praetorian555/Baywatchers/README.md

# Baywatchers
This is the official repository for the team Baywatchers that competed at EUROBOT Serbia 2016.
