praetorian555/Baywatchers/Software/Embedded Software/Misc/IR-senzor/IRsenzor.md

U ovom direktorijumu se nalaze potrebni fajlovi za rad IR senzora. Imena nisma promenila, te se sve nalazi u folderu ULTRASOUND, i mejn 
se zove main_ultrasound... Izmenicu to... Dalje, vrednosti nisu skalirane, a zavisnost rastojanja od vrednosti koje se dobijaju iz ADC 
nalaze se u matlab falju... Ne moramo ih cak ni skalirati, dovoljno je da znamo koje vrednosti odgovaraju kom rastojanju.
