praetorian555/Baywatchers/Software/Embedded Software/Misc/RS485Komunikacija.pdf

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

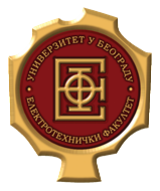
[picture p3: figure]

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

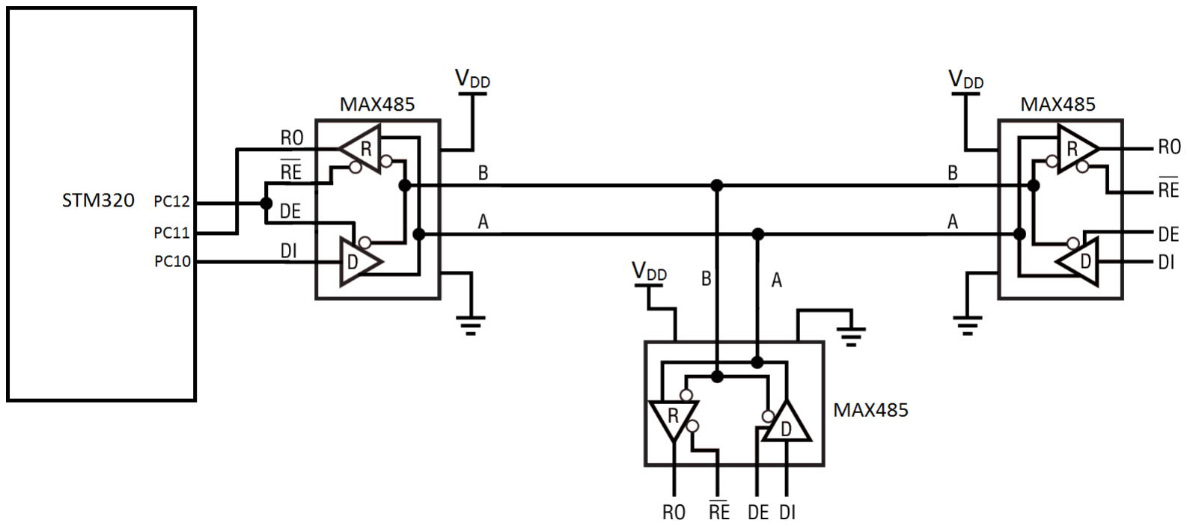
[picture p4: figure]

Tim OE - Cuvari Plaze

# Glava 2

# Protokol poruke

Komunikacioni protokol prema kom se salju poruke preko magistrale je dat na slici 2.

CHECK

SUM START | ADDR | LEN | DATA[1] | . . . . | DATA[N]

Slika 2.1: Prikaz komunikacionog protokola

Prvo se salje START bajt, cija je vrednost 0xF F, i on oznacava pocetak poruke. Sledeci bajt predstavlja adresu uredaja na koji je poruka upucena. Potom sledi bajt koji predstavlja duzinu poruke N koja sledi. Prati ga korisni deo poruke velicine N bajtova. Na kraju se nalazi bajt koji predstavlja check sumu.

Check suma se koristi da bi se ispitala ispravnost poruke. Svi prethodni bajtovi sem start bajta se sabiraju i prvih 7 bita rezultata se poredi sa pristiglom check sumom. Ako su ove dve vrednosti jednake, poruka je validna, u suprotnom se poruka odbacuje.

Do greske u komunikaciji moze da se desi ako jedan bajt u korisnom delu poruke ima vrednost 0xF F sto ustvari predstavlja START bajt. To je reseno na sledeci nacin: Poruka se podeli na grupe od po 7 bajtova, iz svakog bajta se izdvoji bit najvece tezine i tih 7 bita se smesti u poseban bajt HIGH BITS koji se salje pre grupe od 7 bajtova. Ovo je ilustrovano na slici 2.

7F | 70 | 71 | 72 | 73 | 74 | 75 | 76
F0 | F1 | F2 | F3 | F4 | F5 | F6

HIGH BITS

Slika 2.2: Resenje gore-pomenutog problema

Na ovaj nacin svaki bajt nosi 7 bita poruke i ne moze da ima vrednost 0xF F, pa ce poruka biti ispravno poslata.

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

## 3.2 Primer koriscenja API -ja

1 | // ∗∗∗∗∗∗∗∗∗∗∗∗∗∗∗∗∗∗∗∗∗∗∗∗∗∗∗∗∗∗∗∗∗∗∗∗∗∗∗∗∗∗∗∗∗∗∗∗∗∗∗∗∗∗∗∗∗
2 | // ∗∗∗∗∗∗∗∗∗∗∗∗∗∗∗∗∗∗∗∗∗ MASTER ∗∗∗∗∗∗∗∗∗∗∗∗∗∗∗∗∗∗∗∗∗∗∗∗∗∗∗∗
3 | // ∗∗∗∗∗∗∗∗∗∗∗∗∗∗∗∗∗∗∗∗∗∗∗∗∗∗∗∗∗∗∗∗∗∗∗∗∗∗∗∗∗∗∗∗∗∗∗∗∗∗∗∗∗∗∗∗∗
4
5 #include " stm32f10x . h"
6 #include "EUROBOT_serial . h"
7
8 #def ine MASTER_ADDR . . .
9 #def ine MOTOR_DRIVER_ADDR . . . 10
11 v o l a t i l e int ACKflag = 0 ;
12
13 | void DecodeCommand ( ) {
14 | i f ( IsAck ( ) ) ACKflag = 1 ;
15 | // . . . .
16 | }
17 | void d ela y ( int m i l i s ) { . . . }
18
19 | int main ( void)
20 | {
21 | ini tEu robo tRS485 (115200 , MASTER_ADDR, MASTER_ADDR, 1 ) ;
22
23 | int e n co d e r_ ti c k = . . . ;
24 | int i ;
25 | while ( 1 )
26 | {
27
28 | char message [ 5 ] ;
29 | message [ 0 ] = ' f ' ; //Forward
30 | message [ 1 ] = e n co d e r_ ti c k & 0 x000000FF ;
31 | message [ 2 ] = ( e n co d e r_ ti c k >> 8 ) & 0 x000000FF ;
32 | message [ 3 ] = ( e n co d e r_ ti c k >> 16 ) & 0 x000000FF ;
33 | message [ 4 ] = ( e n co d e r_ ti c k >> 24 ) & 0 x000000FF ;
34 | // Pr ob a j 5 pu t a da p o s a l j e s poruku
35 | for ( i = 0 ; i < 5 ; i++){
36 | SendMessage (MOTOR_DRIVER_ADDR, message , 5 ) ;
37 | d ela y (20 ) ;
38 | i f ( ACKflag == 1 ) {
39 | ACKflag = 0 ;
40 | break ;
41 | }
42 | }
43 | i f ( i == 5 ) // Greska u prenosu
44 | // . . . .
45
46 | }
47 | }
| master.c

1
2 | // ∗∗∗∗∗∗∗∗∗∗∗∗∗∗∗∗∗∗∗∗∗∗∗∗∗∗∗∗∗∗∗∗∗∗∗∗∗∗∗∗∗∗∗∗∗∗∗∗∗∗∗∗∗∗∗∗∗
3 | // ∗∗∗∗∗∗∗∗∗∗∗∗∗∗∗∗∗∗∗∗∗∗ SLAVE ∗∗∗∗∗∗∗∗∗∗∗∗∗∗∗∗∗∗∗∗∗∗∗∗∗∗∗∗
4 | // ∗∗∗∗∗∗∗∗∗∗∗∗∗∗∗∗∗∗∗∗∗∗∗∗∗∗∗∗∗∗∗∗∗∗∗∗∗∗∗∗∗∗∗∗∗∗∗∗∗∗∗∗∗∗∗∗∗
5
6 #include " stm32f10x . h"
7 #include "EUROBOT_serial . h"
8
9 #def ine MASTER_ADDR . . .
10 #def ine MOTOR_DRIVER_ADDR . . . 11 #def ine LENGTH . . .
12
13 | v o l a t i l e int f l a g = 0 ;
14 | v o l a t i l e char message [LENGTH] ;
15 | v o l a t i l e char∗ p t r ;
16
17 | void DecodeCommand ( ) {
18 | p t r = GetMessage ( ) ;
19 | // K o p ir an je poruke
20 | for ( int i = 0 ; i < GetMessageLength ( ) ; i++) | message [ i ] = p t r [ i ]
21
22 | f l a g = 1 ;
23 | }
24
25 | int main ( void)
26 | {
27 | // . . . .
28 | ini tEu robo tRS485 (115200 , MASTER_ADDR, MOTOR_DRIVER_ADDR, 1 ) ;
29
30 | char command ;
31 | int e n co d e r_ ti c k ;
32 | while ( 1 )
33 | {
34 | // . . . .
35 | i f ( f l a g == 1 ) {
36 | command = message [ 0 ] ;
37 | e n co d e r_ ti c k = message [ 0 ] + message [ 1 ] ∗ 0 x00000100 +
message [ 2 ] ∗ 0 x00010000 | + message [ 3 ] ∗ 0 x01000000 ;
38 | f l a g = 0 ;
39 | }
40
41 | switch (command ) {
42 | case ' f ' :
43 | // . . .
44 | }
45 | // . . . .
46
47 | }
48 | }
| slave.c

Ovi primeri ilustruju koriscenje API funkcija u koje salju broj otkucaja enkodera sa Mastera na Slave. Master pakuje u jednu poruku komandu koja je predstavljena jednim bajtom i otkucaj enkodera koji je predstavljen sa 4 bajta. To se obavlja pomocu funkcije SendMessage.

Po slanju poruke, Master ceka se ACK signal koji javlja da je poruka uspesno poslata. Ako nije, salje se ponovo. To se ponavlja na primer 5 puta, i ako ponovo ne stigne ACK signal, postoji greska u komunikaciji. ACK signal se prima u DecodeCommand funkciji, i preko ega se signalizira glavnom programu da je stigao.

Slave prima poruku takode u funkciji DecodeCommand. Prvo se kopira poruka u interni niz pomocu GetMessage funkcije, i odredenim egom se signalizira glavni program da je poruka stigla. U glavnom programu se raspakuje poruka koja je dobijena i obavljaju se odredene akcije u zavisnosti od poruke.

# Glava 4

# Opis rada internih funkcija

## 4.1 Slanje poruke

Poruka se salje pomocu funkcija SendMessage ili SendString. One interno pakuju podatke za slanje u sledecu strukturu:

1 | typedef struct {
2 | uint8_t ∗data ; | // Poda tak k o j i se s a l j e
3 | int message_length ; | // Duzina poruke
4 | unsigned int i t e r ; | // I t e r a t o r za pren o s
| p o d a t ak a
5 | } send_package ;

Ova struktura se popunjava tako da protokol bude zadovoljen. Kad se struktura popuni, ona se ubacuje u red za cekanje. Ako je red za cekanje bio prazan, prvi bajt poruke se prosleduje direktno na USART, a ostali bajtovi poruke se salju pomocu prekidne rutine. Deo prekidne rutine koji se bavi slanjem poruke je:

1 | i f ( peekQ ( )−>i t e r < peekQ ( )−>message_length && ! is_emptyQ ( ) )
2 | {
3 | USART_SendData( RS485 , | peekQ ( )−>data [ peekQ ( )−>i t e r ] ) ;
4 | peekQ ( )−>i t e r ++;
5 | }
6 | e l s e
7 | {
8 | d el e t e_la s tQ ( ) ;
9 | i f ( ! is_emptyQ ( ) )
10 | {
11 | USART_SendData( RS485 , | peekQ ( )−>data [ peekQ ( )−>i t e r ] ) ;
12 | }
13 | e l s e
14 | {
15 | DisableRS485 ( ) ;
16 | }
17 | }

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

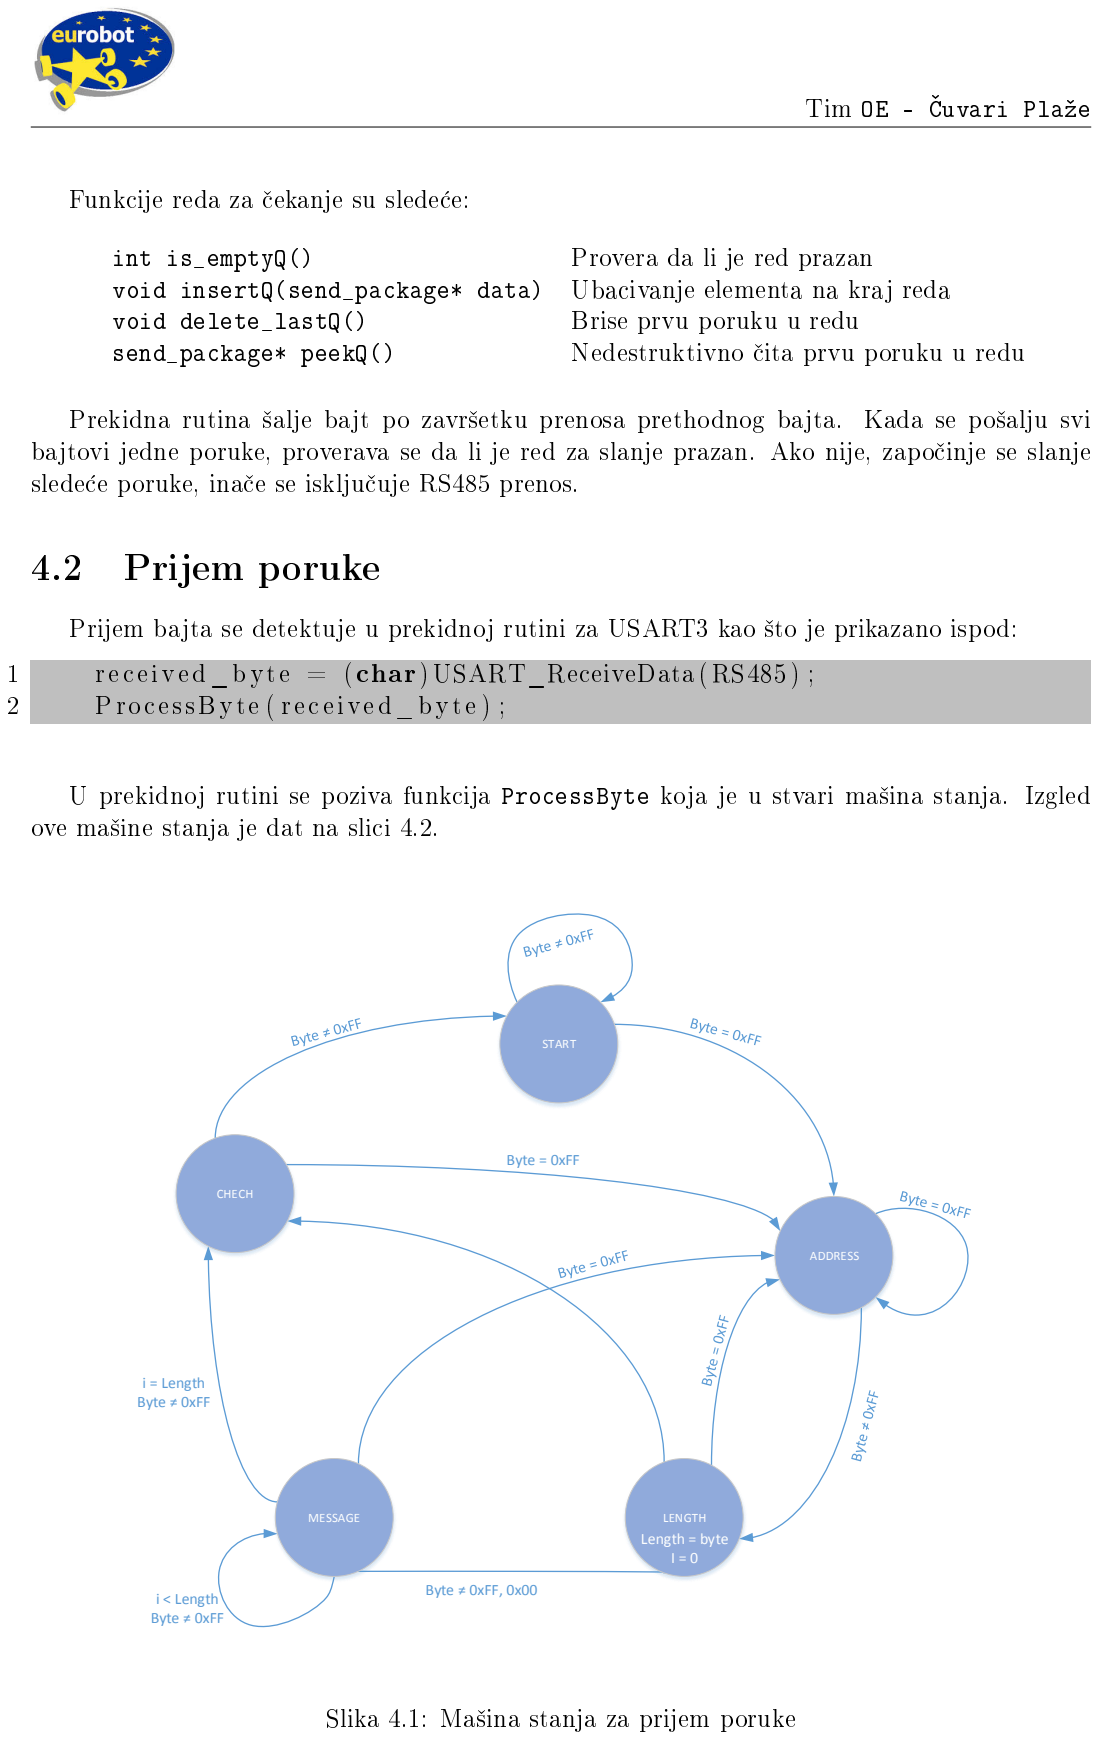
[picture p5: page 12]

Masina stanja je realizovana u skladu sa protokolom za slanje poruke. U stanju CHECK se vrsi provera da li je poruka validna, tj da li je check suma odgovarajuca. Ako jeste izvrsava se sledeci deo koda:

1 | Ex t rac tMe s sage ( r e c e i v e d . prev_data , ( char ∗) r e c e i v e d . data ) ;
2 | r e c e i v e d . p rev_leng th = r e c e i v e d . message_length −
| ( r e c e i v e d . message_length /8 + ( r e c e i v e d . message_length % 8 != 0 ) ) ;
3 | r e c e i v e d . prev_add ress = ( char ) r e c e i v e d . a d d r e s s ;
4
5 | // Ako j e ovo SLAVE v r a t i ACK
6 | i f ( ! Thi sDevice . i s_ma s te r ) {
7 | i f ( ! IsAck ( ) && Thi sDevice . thi s_add r == r e c e i v e d . a d d r e s s )
| SendACK( Thi sDevice . master_addr ) ;
8 | }
9
10 | DecodeCommand ( ) ;
11 | } co n t e n t

Funkcija ExtractMessage daje konvertuje poruku iz oblika koji je bio pogodan za protokol(7 korisnih bita po bajtu, slika 2) u zeljenu poruku. Takode se odreduje duzina korisnog dela poruke.

ACK signal se prosleduje masteru samo ako je u pitanju Slave uredaj, i ako je adresa odgovarajuca. Ovde je pretpostavljeno da Slave uredaju ne treba ACK signal od Mastera kad mu Slave posalje poruku. Moguce je ispraviti da se ACK salje u svakom slucaju.

Na kraju se izvrsava DecodeCommand funkcija koju korisnik drajvera denise u zavisnosti od svojih potreba. U toj funkciji moze da se detektuje da li je stigao ACK signal, ili da se preuzme primljena poruka. Ova funkcija se izvrsava u prekidnoj rutini, tako da ne bi trebalo da se dugo izvrsava.

# Napomene

- Onaj ko bude koristio ovaj drajver treba da vidi da li je nacin slanja ACK signala odgovarajuci. Ako je potrebno da se menja(Da se doda ID poruke i ACK-a koji mu salje itd), slanje ACK signala se nalazi u funkciji ProcessByte, case: CHECK
- Potrebno je denisati adrese uredaja koji se salju.
- Prioritet prekida USART3 prekidne rutine je podesen u funkciji initEurobotRS485. Po potrebi ga promeniti, ja nisam znao koliki prioritet treba da bude.
- Ne bi trebalo slati dosta poruka jednu za drugom(Jedna komanda SendMessage iza druge). Iako bi komunikacija i tad trebala da radi, moze da dodje do zatrpavanja memorije.
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
