praetorian555/Baywatchers/Software/Embedded Software/Motion Board/OCR_low.c

const unsigned char OCR_low[]={25,12.5,93.5,134,107,174.5,40,195,116.5,53.5,2,215,179,148,121,97.5,76.5,58,41.5,26.5,13,1,245.5,235.5,226,217.5,209.5,202,195,188.5,182,176.5,171,166,161.5,157,152.5,148.5,145,141,137.5,134.5,131.5,128.5,125.5,122.5,120,117.5,115,113,110.5,108.5,106.5,104.5,102.5,101,99,97.5,95.5,94,92.5,91,89.5,88,87,85.5,84,83,81.5,80.5,79.5,78.5,77,76,75,74,73,72.5,71.5,70.5,69.5,68.5,68,67,66.5,65.5,65,64,63.5,62.5,62,61,60.5,60,59.5,58.5,58,57.5,57,56.5
};
