praetorian555/Baywatchers/Software/Embedded Software/Motion Board/acc_table_Y.c

const unsigned int acc_table_Y[]={0,10,15,27,35,53,53,87,101,115,147,164,164,164,265,289,338,364,419,448,508,540,573,641,677,677,677,677,911,997,1042,1133,1181,1278,1328,1379,1484,1539,1650,1706,1823,1883,2000,2000,2000,2000,2000,2000,2000,2000,2000,2000,2000,2000,2000,2000,2000,2000,2000,2000,2000,2000,2000,2000,2000,2000,2000,2000,2000,2000,2000,2000,2000,2000,2000,2000,2000,2000,2000,2000,2000,2000,2000,2000,2000,2000,2000,2000,2000,2000,2000,2000,2000,2000,2000,2000,2000,2000,2000,2000
};
