praetorian555/Baywatchers/Software/Embedded Software/Motion Board/acc_table_Z.c

const unsigned int acc_table_Z[]={0,7,7,7,7,7,7,7,26,26,26,26,26,26,26,26,26,58,58,58,58,58,58,58,58,58,58,58,58,58,58,58,58,58,58,160,160,160,160,160,160,160,160,160,231,231,231,231,231,231,231,231,231,231,231,231,231,231,231,231,231,231,231,410,410,410,410,410,410,410,410,410,520,520,520,520,520,520,520,520,520,642,642,642,642,642,642,642,642,642,777,777,777,777,777,777,777,777,2000,2000
};
